AidenRoto/Bluetooth-keyboard-adapter/readme_img/configurator.png

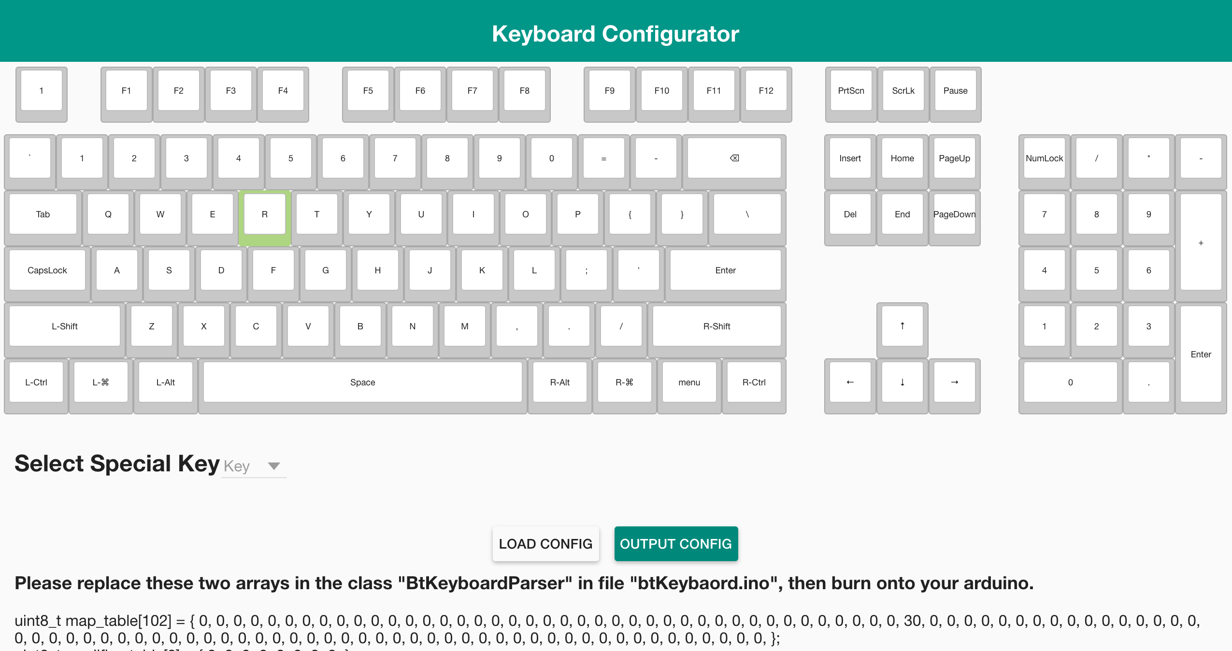
readme_img/configurator.png
