AidenRoto/Bluetooth-keyboard-adapter/(commit log)

2016-06-10 add basic arduino controller logic
2016-06-13 reduce power consumption
2016-06-13 add power control to readme
2016-06-14 add key redefine feature prototype
2016-06-14 hide load configure button
2016-06-19 add precision and switch key setting interface
2016-06-22 fix mouse bug in substituding hid code
    [btKeyboard.ino]
